MissouriMRDT/RoveSoCameraServer_Hardware/README.md

# RoveSoCameraServer

This is the repository for a custom camera server using a Jetson Xavier NX and the GMSL2 protocol.
