MissouriMRDT/RoveSoCameraServer_Hardware/simulation/5V_Buck.asc

C1: cap; 22µ
C2: cap; 3.3n
C3: cap; 0.1µ
C4: cap; 10µ
I1: current; 1; load
L1: ind; 2.2µ
R1: res; 100k
U2: TPS62133_TRANS
V1: voltage; 12
Named nets: 0, +5V
.tran 2
.measure
