MissouriMRDT/RoveSoCameraServer_Hardware/simulation/Serializer_POC.asc

C1: cap; 10n
C2: cap; 100n
L1: ind; 560n; Rser=120m Cpar=0.126p
L2: ind; 6.8µ; Rser=130 Cpar=0.190p
L3: ind; 22µ; Rser=495m Cpar=2.879p
R1: res; 5k
R2: res; 5k
V1: voltage; SINE(0 3 187m); AC 3; Rser=1m
V2: voltage; SINE(0 3 3g); AC 3; Rser=1m
V3: voltage; 12; Rser=1m
Named nets: 0
.ac dec 100 1 3G
