MissouriMRDT/RoveSoCameraServer_Hardware/(list of files, drawings)

Other design files:
simulation/TPS62132_PSPICE_TRANS/TPS62132_TRANS.OLB
simulation/TPS62132_PSPICE_TRANS/TPS62132_TRANS.opj
simulation/TPS62133_PSPICE_TRANS/TPS62133_TRANS.OLB
simulation/TPS62133_PSPICE_TRANS/TPS62133_TRANS.opj
