MissouriMRDT/RoveSoCameraServer_Hardware/Camera_Serializer/Camera_serializer.kicad_pcb

## KiCad design Camera_Serializer/Camera_serializer.kicad_pcb (2025-10-25)

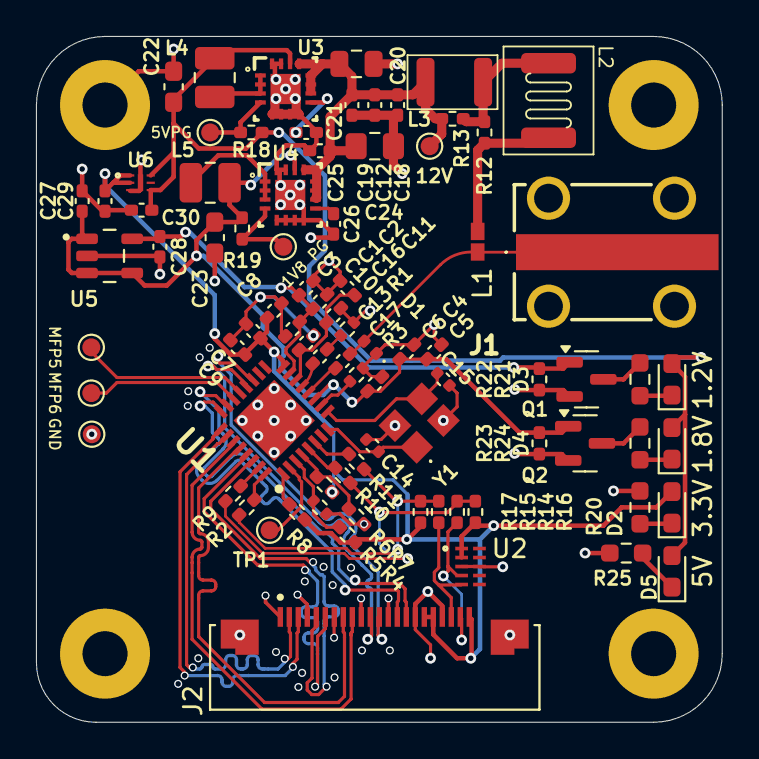
[picture p1: board Camera_serializer.kicad_pcb from above]

Board: 4 copper layers, 38.1 x 38.1 mm, 87 parts (0 on the bottom side), 52 nets.

Parts:
C1, C4, C7, C16, C18: 10n; C_0402_1005Metric_Pad0.74x0.62mm_HandSolder
C2, C5, C8, C10, C12, C13, C17: 100n; C_0402_1005Metric_Pad0.74x0.62mm_HandSolder
C3, C6, C9, C11: 10u; C_0402_1005Metric_Pad0.74x0.62mm_HandSolder
C14, C15: 13pF; C_0402_1005Metric
C19, C25: 0.1uF; C_0402_1005Metric_Pad0.74x0.62mm_HandSolder
C20: 10uF; C_0805_2012Metric
C21, C26: 3.3nF; C_0402_1005Metric_Pad0.74x0.62mm_HandSolder
C22, C23: 22uF; C_0603_1608Metric_Pad1.08x0.95mm_HandSolder
C24: 10uF; C_0805_2012Metric_Pad1.18x1.45mm_HandSolder
C27, C28, C29, C30: 1uF; C_0402_1005Metric_Pad0.74x0.62mm_HandSolder
D1: D_0402_1005Metric
D2, D3, D4, D5: GREEN; LED_0603_1608Metric_Pad1.05x0.95mm_HandSolder
H1, H2, H3, H4: MountingHole_Pad; MountingHole_2.5mm_Pad
J1: 7-2287906-0
J2: F32Q-1A7H1-11022
L1: 560n; PFL1609-561MEW
L2: 6u8; 1812PS-682JRC
L3: 22u; SRN3015C-220M
L4, L5: 2.2uH; L_1008_2520Metric
Q1, Q2: BSS138; SOT-23
R1: 49.9; R_0402_1005Metric
R2, R9, R10, R11: 0R; R_0402_1005Metric_Pad0.72x0.64mm_HandSolder
R3: 402; R_0402_1005Metric
R4, R7: R_0402_1005Metric_Pad0.72x0.64mm_HandSolder
R5: 10k; R_0402_1005Metric
R6: 10k; R_0402_1005Metric_Pad0.72x0.64mm_HandSolder
R8: 10K; R_0402_1005Metric_Pad0.72x0.64mm_HandSolder
R12, R13: 5k; R_0402_1005Metric_Pad0.72x0.64mm_HandSolder
R14, R15: 100; R_0402_1005Metric_Pad0.72x0.64mm_HandSolder
R16, R17: 4k7; R_0402_1005Metric_Pad0.72x0.64mm_HandSolder
R18, R19, R22, R23: 100k; R_0402_1005Metric_Pad0.72x0.64mm_HandSolder
R20: 330; R_0603_1608Metric_Pad0.98x0.95mm_HandSolder
R21, R24, R25: 820; R_0603_1608Metric_Pad0.98x0.95mm_HandSolder
TP1, TP2, TP3, TP4, TP5, TP7, TP8: TestPoint; TestPoint_Pad_D1.0mm
U1: QFN50P500X500X80-33N
U2: PUSB3FR4Z
U3: TPS62133RGTR
U4: TPS62131RGTT; TPS62133RGTR
U5: TPS73601DBVR
U6: MIC5528-3.3YMT-TR; TDFN6_1P2X1P2_MCH
Y1: EB2532YA08-25.000M_TR

Connections:
+1V2: C1.1, C2.1, C3.1, C28.1, Q1.1 (G), R22.1, U1.15 (VDD), U5.5 (OUT)
+1V8: C4.1, C5.1, C6.1, C23.1, C27.1, L5.2, Q2.1 (G), R19.1, R23.1, U1.11 (VDD18), U4.14 (VOS), U5.1 (IN), U5.3 (EN), U5.4 (NR/FB)
+3V3: C7.1, C8.1, C9.1, C29.1, D2.2 (A), J2.17, J2.18, J2.22, R4.2, R6.1, R8.1, R16.2, R17.2, U1.16 (VDDIO), U2.1, U2.2, U6.1 (VOUT), U6.2 (VOUT)
+5V: C22.1, C30.1, D3.2 (A), D4.2 (A), D5.2 (A), L4.2, R18.1, U3.14 (VOS), U6.4 (EN), U6.6 (VIN)
+12V: C12.1, C18.1, C19.1, C20.1, C24.1, C25.1, L3.2, R13.1, TP4.1, U3.10 (AVIN), U3.11 (PVIN), U3.12 (PVIN), U3.13 (EN), U4.10 (AVIN), U4.11 (PVIN), U4.12 (PVIN), U4.13 (EN)
/GMSL_Connector/SIOP_COAX: C17.2, D1.2, J1.1, L1.1
/csi/CAM_SCL: J2.20, R15.1, U2.5
/csi/CAM_SDA: J2.21, R14.1, U2.4
/csi/CSI.CK_N: J2.8, U1.28 (CKN)
/csi/CSI.CK_P: J2.9, U1.27 (CKP)
/csi/CSI.D0_N: J2.2, U1.26 (D0N)
/csi/CSI.D0_P: J2.3, U1.25 (D0P)
/csi/CSI.D1_N: J2.5, U1.30 (D1N)
/csi/CSI.D1_P: J2.6, U1.29 (D1P)
/csi/CSI.D2_N: J2.11, U1.20 (D2N)
/csi/CSI.D2_P: J2.12, U1.19 (D2P)
/csi/CSI.D3_N: J2.14, U1.24 (D3N)
/csi/CSI.D3_P: J2.15, U1.23 (D3P)
/csi/I2C.SCL: R2.2, R11.2, R15.2, R17.1
/csi/I2C.SDA: R9.2, R10.2, R14.2, R16.1
/serializer/CFG0: R4.1, R5.2, U1.3 (MFP1/CFG0)
/serializer/CFG1: R6.2, R7.1, U1.4 (MFP2/CFG1)
/serializer/PWDN: R8.2, U1.1 (PWDNB)
/serializer/X1: C14.1, U1.8 (X1/OSC), Y1.1
/serializer/X2: C15.1, U1.9 (X2), Y1.3
/serializer/XRES: R3.2, U1.10 (XRES)
GND: C1.2, C2.2, C3.2, C4.2, C5.2, C6.2, C7.2, C8.2, C9.2, C10.2, C11.2, C12.2, C14.2, C15.2, C16.2, C18.2, C19.2, C20.2, C21.2, C22.2, C23.2, C24.2, C25.2, C26.1, C27.2, C28.2, C29.2, C30.2, D1.1, H1.1, H2.1, H3.1, H4.1, J1.2, J1.3, J1.4, J1.5, J2.1, J2.4, J2.7, J2.10, J2.13, J2.16, J2.19, J2.SH1, J2.SH2, Q1.2 (S), Q2.2 (S), R1.2, R3.1, R5.1, R7.2, R20.2, R22.2, R23.2, R25.2, TP8.1, U1.33 (GND), U2.3, U2.8, U3.5 (FB), U3.6 (AGND), U3.7 (FSW), U3.8 (DEF), U3.15 (PGND), U3.16 (PGND), U3.17 (EP), U4.5 (FB), U4.6 (AGND), U4.7 (FSW), U4.8 (DEF), U4.15 (PGND), U4.16 (PGND), U4.17 (EP), U5.2 (GND), U6.3 (GND), U6.7 (EPAD), Y1.2, Y1.4
unnamed: C13.1, R1.1
unnamed: D2.1 (K), R20.1
unnamed: D3.1 (K), R21.1
unnamed: D4.1 (K), R24.1
unnamed: D5.1 (K), R25.1
unnamed: L1.2, L2.1, R12.2
unnamed: L2.2, L3.1, R12.1, R13.2
unnamed: L4.1, U3.1 (SW), U3.2 (SW), U3.3 (SW)
unnamed: L5.1, U4.1 (SW), U4.2 (SW), U4.3 (SW)
unnamed: Q1.3 (D), R21.2
unnamed: Q2.3 (D), R24.2
unnamed: C10.1, C11.1, C16.1, U1.14 (CAP_VDD)
unnamed: TP1.1, U1.2 (MFP0)
unnamed: TP2.1, U1.21 (MFP5)
unnamed: TP3.1, U1.22 (MFP6)
unnamed: R9.1, U1.31 (MFP7)
unnamed: R2.1, U1.32 (MFP8)
unnamed: R10.1, U1.5 (MFP9)
unnamed: R11.1, U1.6 (MFP10)
unnamed: C13.2, U1.13 (SION)
unnamed: C17.1, U1.12 (SIOP)
unnamed: R18.2, TP5.1, U3.4 (PG)
unnamed: C21.1, U3.9 (SS_TR)
unnamed: R19.2, TP7.1, U4.4 (PG)
unnamed: C26.2, U4.9 (SS_TR)
