MissouriMRDT/RoveSoCameraServer_Hardware/(commit log)

2024-10-29 Initial project setup
    [RoveSoCameraServer.kicad_pcb, RoveSoCameraServer.kicad_sch]
2024-10-30 Added SODIMM connector for Jetson
    [RoveSoCameraServer.kicad_pcb, RoveSoCameraServer.kicad_sch]
2024-11-02 Added camera serializer and libraries
    [Camera_serializer.kicad_pcb, Camera_serializer.kicad_sch, Power.kicad_sch, serializer.kicad_sch]
2024-11-02 Added serializer schematic and fakra connector
    [Camera_serializer.kicad_pcb, Camera_serializer.kicad_sch, serializer.kicad_sch]
2024-11-16 Added crystal and capacitor, plus config resistors
    [serializer.kicad_sch]
2024-11-25 Basic setup of main SOC done, working on POC circuit now.
    [Camera_serializer.kicad_sch, Power.kicad_sch, serializer.kicad_sch]
2024-11-29 Finished POC circuit and added TVS diode
    [Camera_serializer.kicad_sch, Power.kicad_sch, serializer.kicad_sch]
2024-12-26 Added CSI connector
    [Camera_serializer.kicad_sch, Power.kicad_sch, csi.kicad_sch, serializer.kicad_sch]
2024-12-26 Added tvs diodes
    [Camera_serializer.kicad_sch, csi.kicad_sch]
2024-12-26 Finished CSI interface
    [csi.kicad_sch]
2024-12-28 Added 5V buck
    [Camera_serializer.kicad_sch, GMSL_Connector.kicad_sch, csi.kicad_sch, power_converters.kicad_sch, serializer.kicad_sch]
2024-12-28 Finished power converters
    [power_converters.kicad_sch]
2024-12-29 Finishe schematic
    [Camera_serializer.kicad_pcb, Camera_serializer.kicad_sch, GMSL_Connector.kicad_sch, csi.kicad_sch, power_converters.kicad_sch, serializer.kicad_sch]
2024-12-29 Layout started
    [Camera_serializer.kicad_pcb, Camera_serializer.kicad_sch, power_converters.kicad_sch]
2024-12-30 Switched out 1.2V LDO for better one
    [csi.kicad_sch, power_converters.kicad_sch]
2025-01-02 All components placed in correct positions
    [Camera_serializer.kicad_pcb, csi.kicad_sch, power_converters.kicad_sch]
2025-01-02 Routed most traces except CSI lines
    [Camera_serializer.kicad_pcb]
2025-01-04 Finished routing
    [Camera_serializer.kicad_pcb, GMSL_Connector.kicad_sch, power_converters.kicad_sch]
2025-01-25 Finished differential routing
    [CSI-2.kicad_sch, Camera_serializer.kicad_pcb, GMSL_Connector.kicad_sch, csi.kicad_sch, power_converters.kicad_sch, serializer.kicad_sch]
2025-01-28 Fixed power IC disconnected on schematic
    [Camera_serializer.kicad_pcb, power_converters.kicad_sch]
2025-01-29 Finished Rev1
    [Camera_serializer.kicad_pcb]
2025-10-25 Updated to Kicad 9 and added datasheet for 22uH inductor
    [Camera_serializer.kicad_pcb, Camera_serializer.kicad_sch, GMSL_Connector.kicad_sch, csi.kicad_sch, power_converters.kicad_sch, serializer.kicad_sch]
2025-11-04 Added buck simulation
    [TPS62132_TRANS.OLB, TPS62132_TRANS.opj, TPS62133_TRANS.OLB, TPS62133_TRANS.opj]
2025-11-04 Add 5V buck converter and update gitignore
